fedecastellaro/Arterial-Pressure-and-ECG-Measurer/Circuito_Amp_ECG/ALIMENTACION OP.png

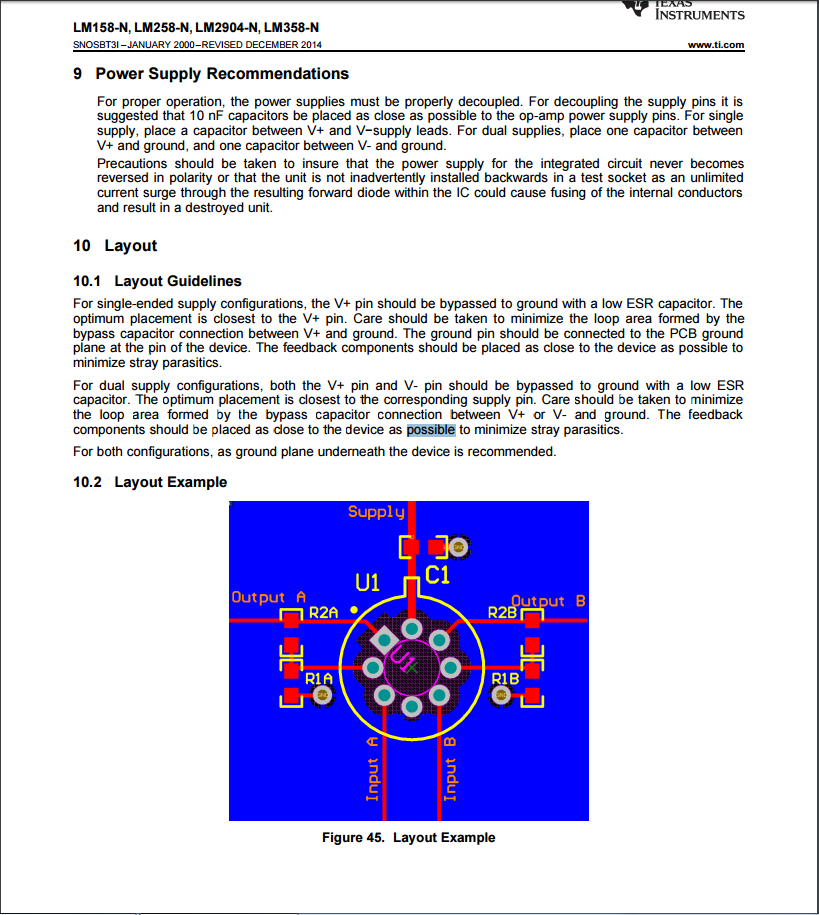
Circuito_Amp_ECG/ALIMENTACION OP.png
