fedecastellaro/Arterial-Pressure-and-ECG-Measurer/(list of files, drawings)

Other design files:
Circuito_Amp_ECG/PCB_PreAmp_2017.PrjPcb
Circuito_Amp_ECG/Pre-Amp_2017.SchDoc
Circuito_Amp_ECG/Pre_Amp_2017.PcbDoc
