fedecastellaro/Arterial-Pressure-and-ECG-Measurer/Medidor_ECG_LPC1769/drivers_lpc1769/src/crp.c

//*****************************************************************************
// crp.c
//
// Source file to create CRP word expected by LPCXpresso IDE linker
//*****************************************************************************
//
// Copyright(C) NXP Semiconductors, 2013
// All rights reserved.
//
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
// Permission to use, copy, modify, and distribute this software and its
// documentation is hereby granted, under NXP Semiconductors' and its
// licensor's relevant copyrights in the software, without fee, provided that it
// is used in conjunction with NXP Semiconductors microcontrollers.  This
// copyright, permission, and disclaimer notice must appear in all copies of
// this code.
//*****************************************************************************

#if defined (__CODE_RED)
#include <NXP/crp.h>
// Variable to store CRP value in. Will be placed automatically
// by the linker when "Enable Code Read Protect" selected.
// See crp.h header for more information
__CRP const unsigned int CRP_WORD = CRP_NO_CRP;
#endif
